woshizuopie/Auto_charge_in_pile/Doc/注意事项.docx

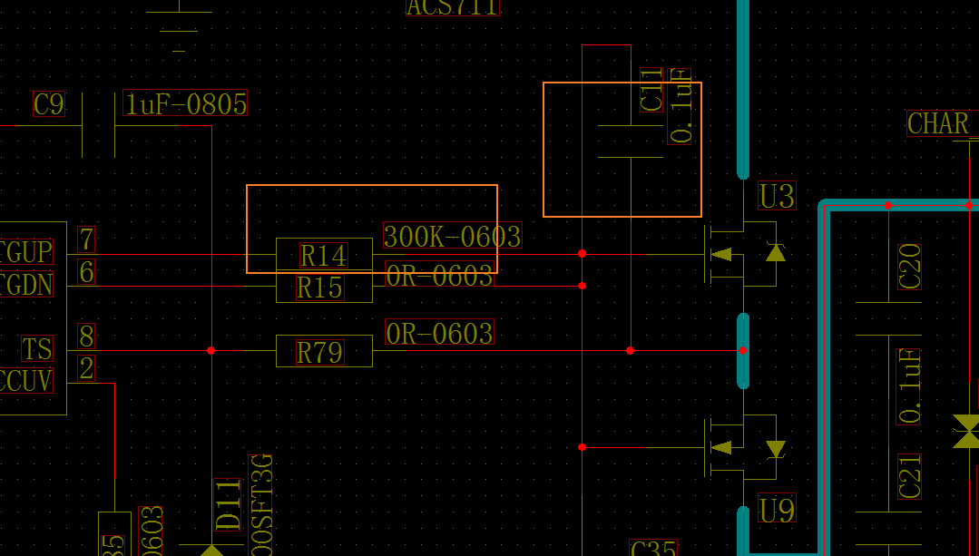
[picture p1: figure]

300K换成500K解决低电量充电桩的板卡硬件过流问题
