woshizuopie/Auto_charge_in_pile/Doc/PJ0006_PW3-A01 2020-09-09.pdf

D

6 | 5 | 4 | 3 | 2 | 1

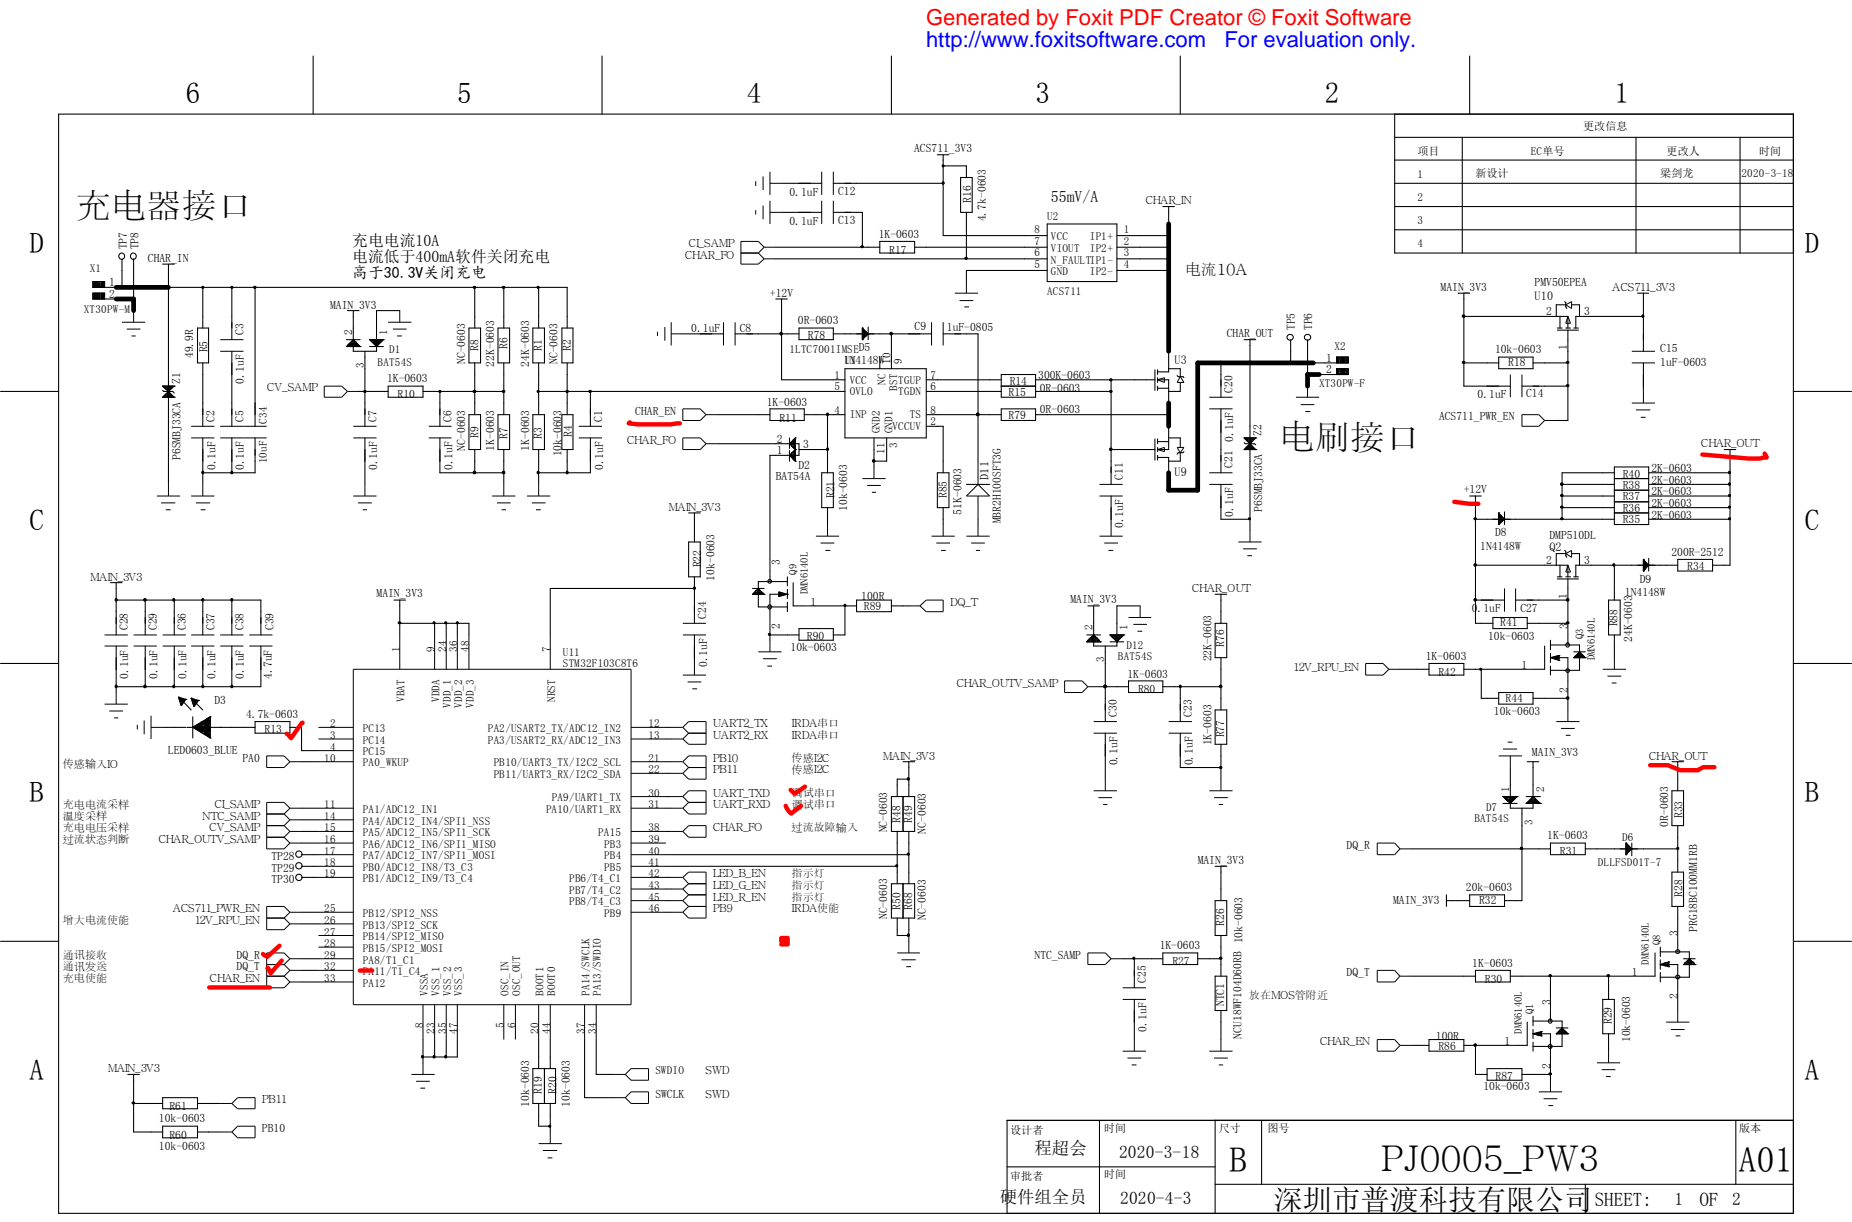
[picture p2: page 1]

Generated by Foxit PDF Creator © Foxit Software
http://www.foxitsoftware.com For evaluation only.

ACS711_3V3 | 更改信息

项目 | EC单号 | 更改人 | 时间

1 | | 梁剑龙 | 2020-3-18新设计

D

6 | 5 | 4 | 3 | 2 | 1

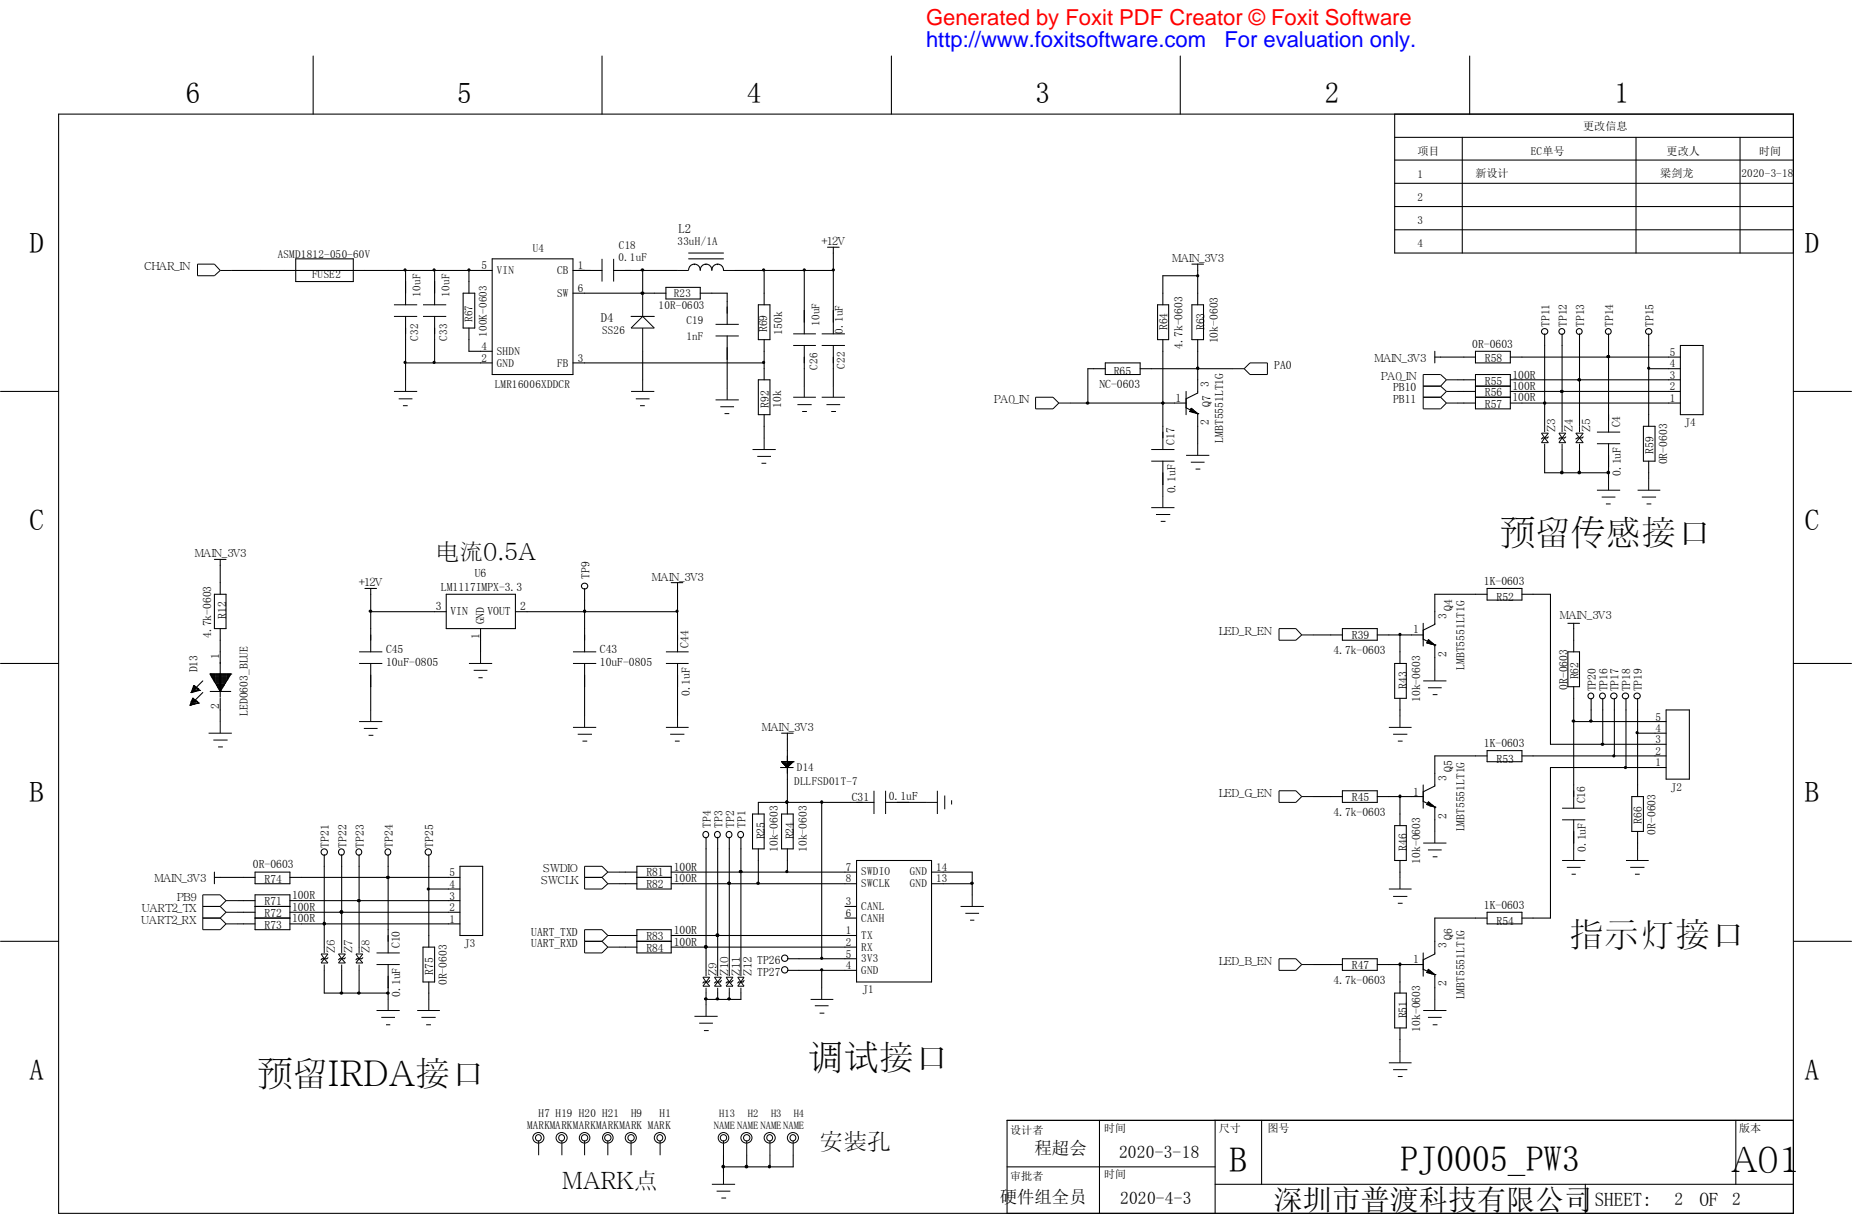
[picture p3: page 2]

Generated by Foxit PDF Creator © Foxit Software
http://www.foxitsoftware.com For evaluation only.

+12V U4 | 更改信息

项目 | EC单号 | 更改人 | 时间

1 | | 梁剑龙 | 2020-3-18新设计
