woshizuopie/Auto_charge_in_pile/Doc/PJ0006_PW3-A01_WH.pdf

R43

R45

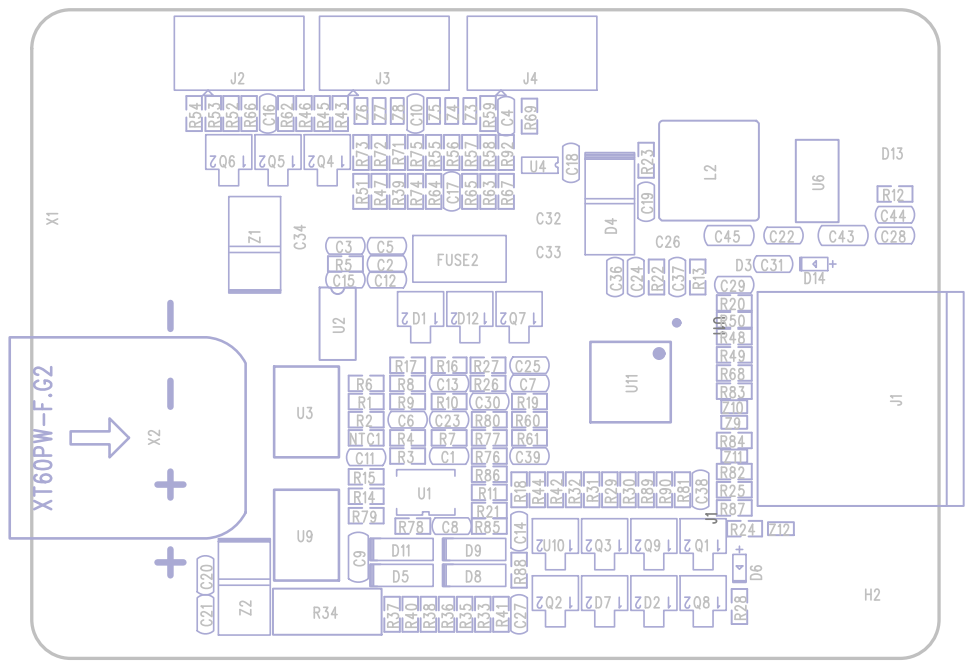
[picture p4: page 1]
