woshizuopie/Auto_charge_in_pile/(list of files, drawings)

Other design files:
Doc/PJ0006_PW3-A02.pcb
